microrack/attvert/(commit log)

2020-11-04 fix resistance
    [attvert.sch]
2020-11-11 Make PCB. Add LEDs. Add power connection U2.
    [attvert.kicad_pcb, attvert.sch]
2020-11-11 Remove silk from solder pads Rotate RV3
    [attvert.kicad_pcb]
2020-11-11 Repare silk
    [attvert.kicad_pcb]
2020-11-21 Change led's current resistor 100R to 1K
    [attvert.sch]
2020-11-29 Change power connectors add protect power +9V line
    [attvert.kicad_pcb, attvert.sch]
2020-11-30 update silk
    [attvert.kicad_pcb]
2020-12-15 add logo PCB
    Change position R43
    [attvert.kicad_pcb]
